Fmulder007/1freq-FM/PHOTO/image_2026-10-05_02-39-06.jpg

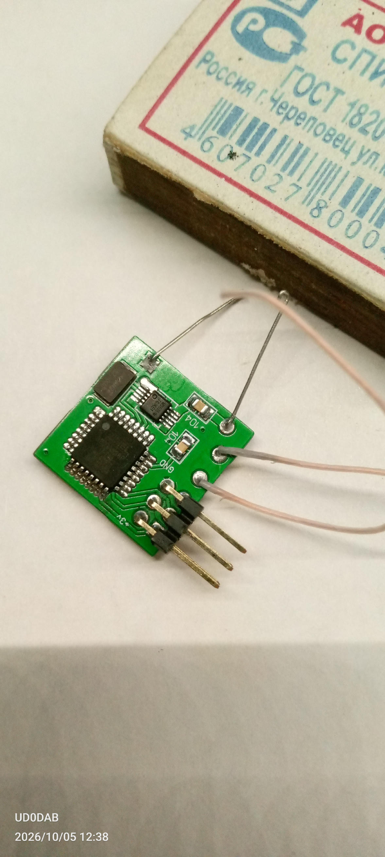
PHOTO/image_2026-10-05_02-39-06.jpg
