Fmulder007/1freq-FM/FUSES.JPG

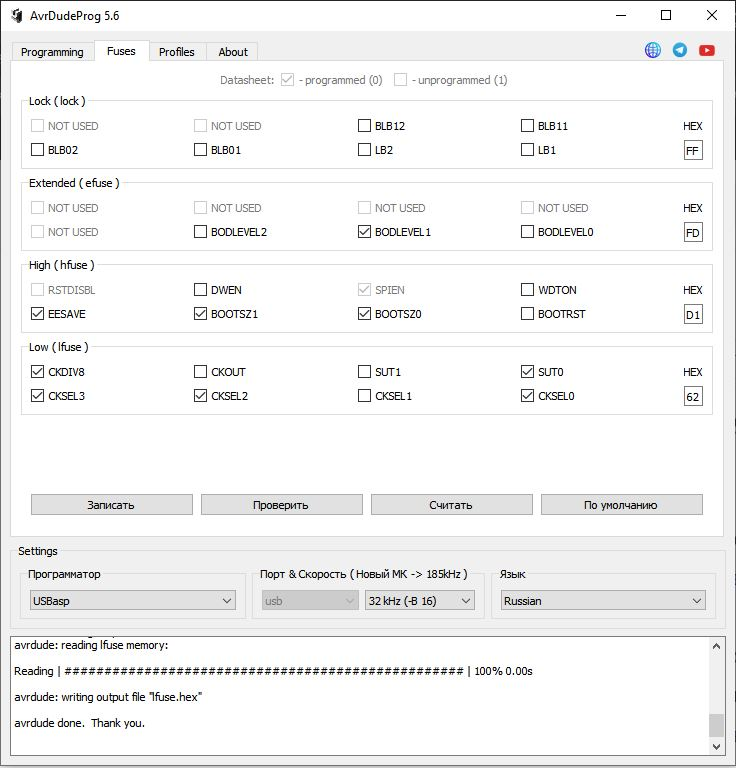
FUSES.JPG
