Fmulder007/1freq-FM/LAY/BACK.JPG

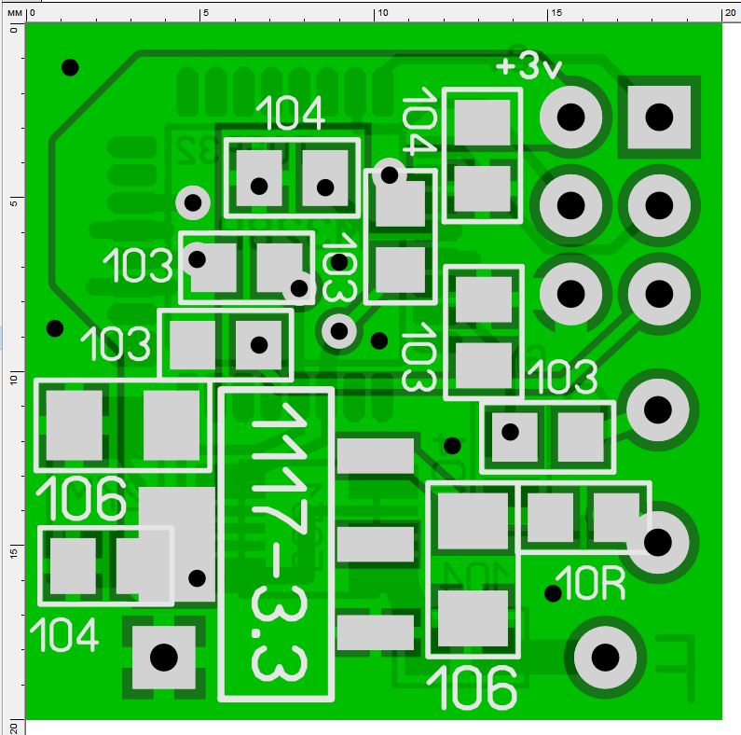
LAY/BACK.JPG
