Fmulder007/1freq-FM/LAY/FRONT.JPG

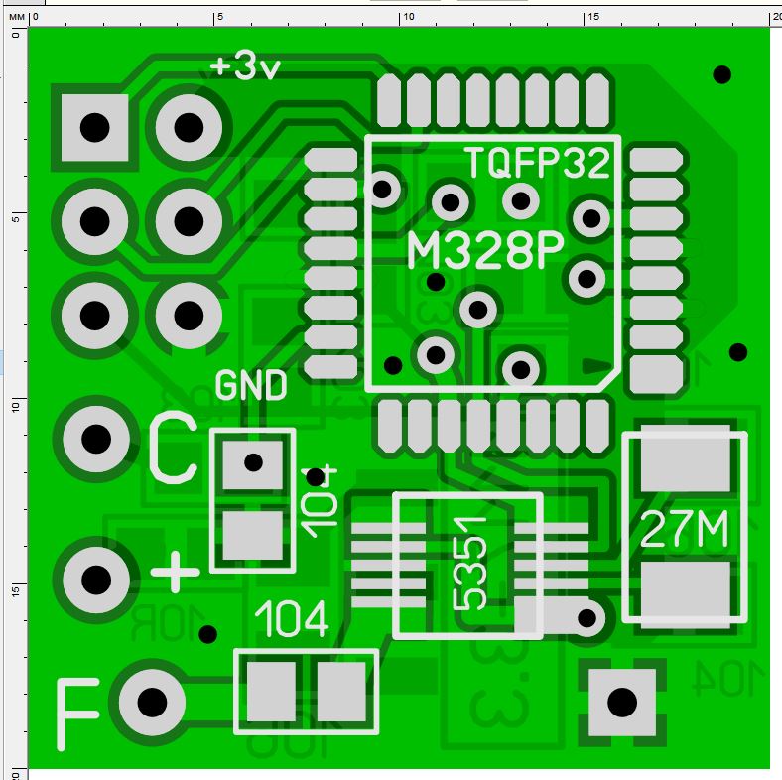
LAY/FRONT.JPG
