Fmulder007/1freq-FM/(list of files, drawings)

Other design files:
LAY/M328_1freq.lay6
